fangrui166/GroundLock/old/read me.txt

版本介绍：
INT_GL_0.3 是北京第一台样机的程序；
INT_GL_0.3 - allsts 是地磁加超声波在后来自定义的协议上做的一版；
