fangrui166/GroundLock/doc/地锁6新主板电路图.pdf

# 地锁控制板更新：

# 1、取消集成超声波电路，改为外置超声波模块

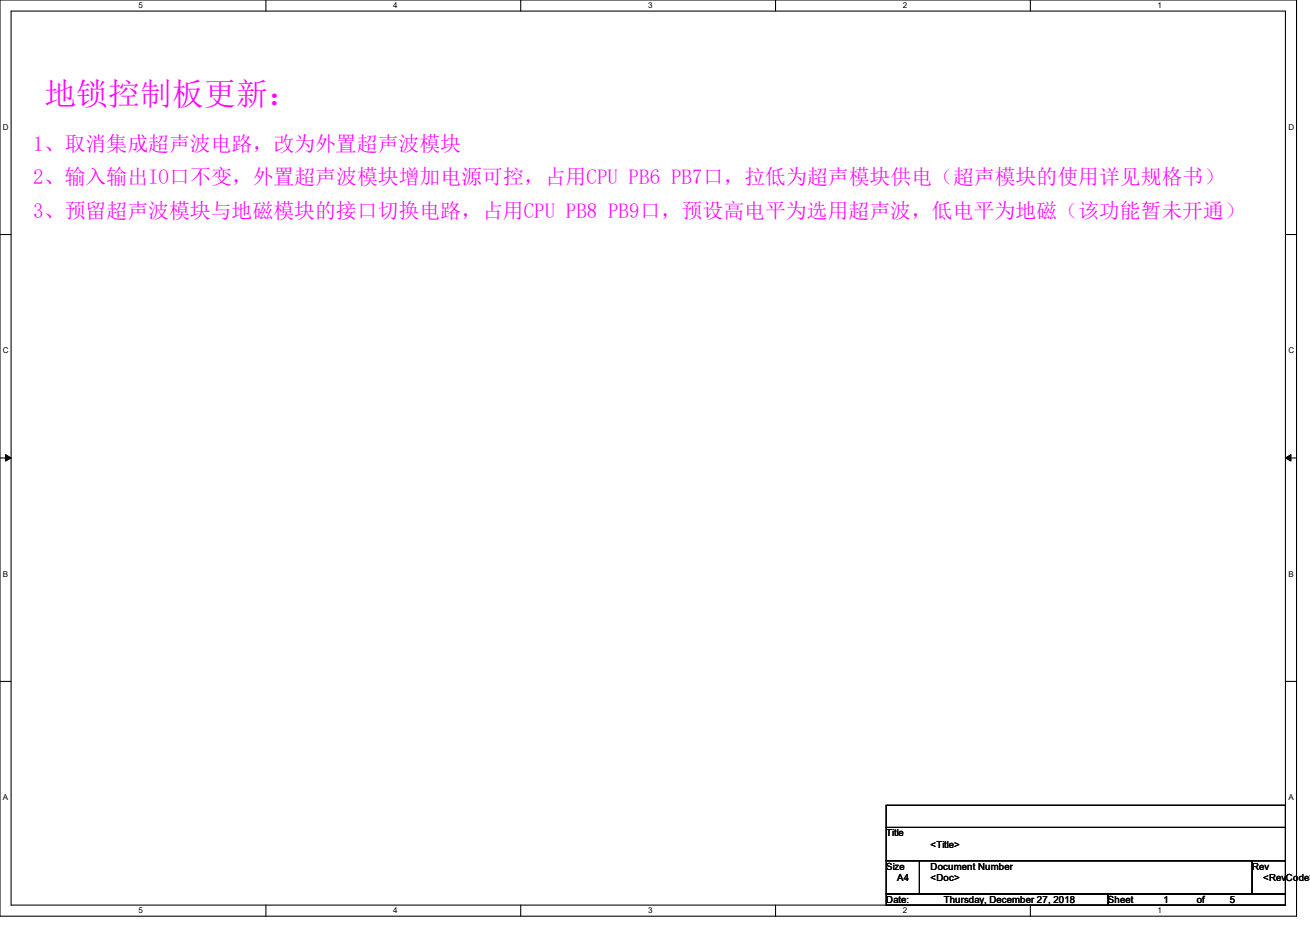
[picture p17: page 1]
Title Size; Document Number; Rev Date:; Sheet; of <Doc>; <RevCode>; <Title> A4; Thursday, December 27, 2018; 5 Title Size

2、输入输出IO口不变，外置超声波模块增加电源可控，占用CPU PB6 PB7口，拉低为超声模块供电（超声模块的使用详见规格书）
3、预留超声波模块与地磁模块的接口切换电路，占用CPU PB8 PB9口，预设高电平为选用超声波，低电平为地磁（该功能暂未开通）

# CPU主控

# OSC_IN OSC_OUT OSC_IN OSC_OUT ADC

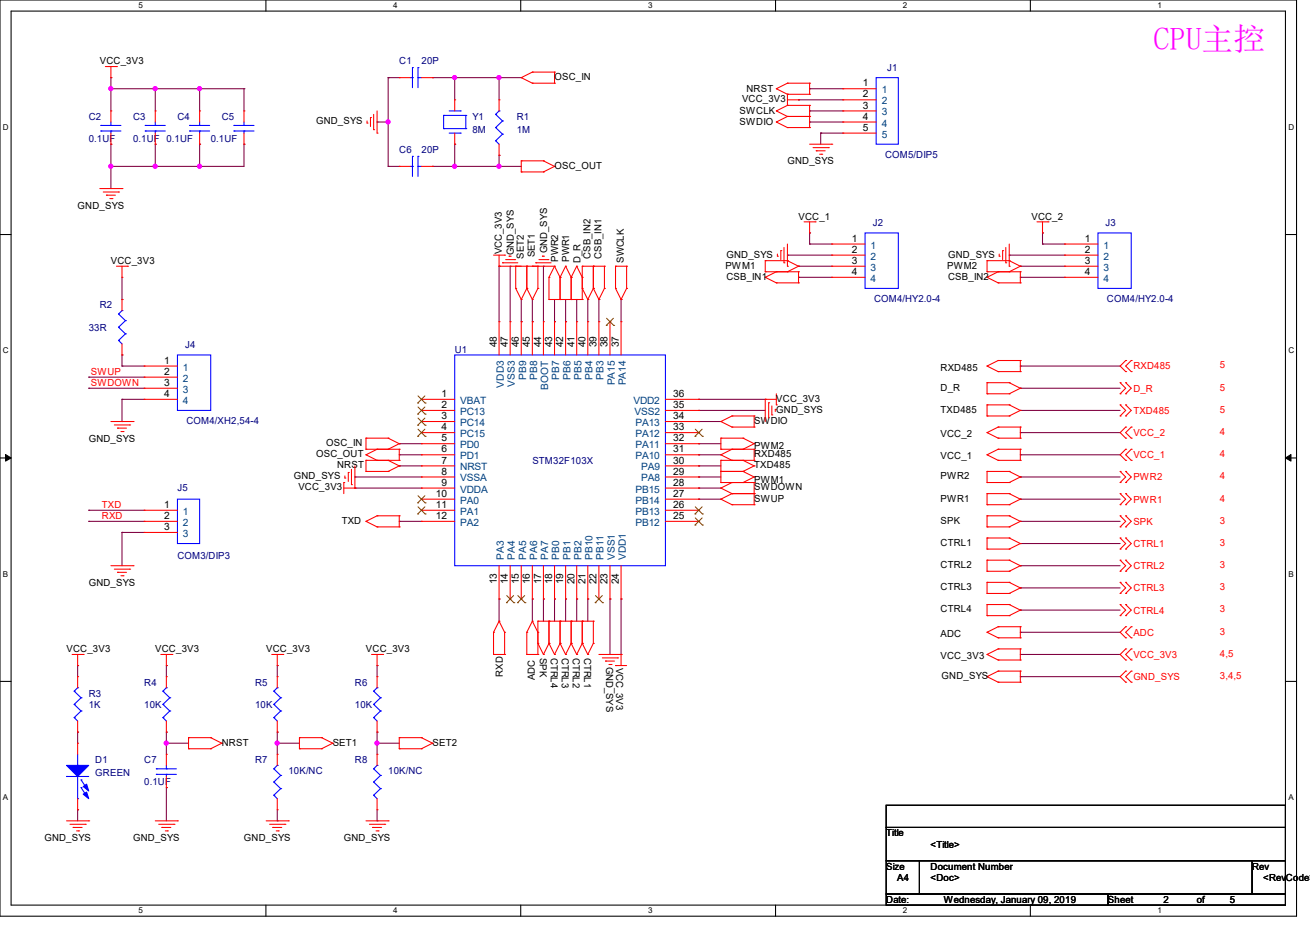
[picture p18: page 2]

# 升降电机驱动

# VCC_24V CTRL4 CTRL3 ADC

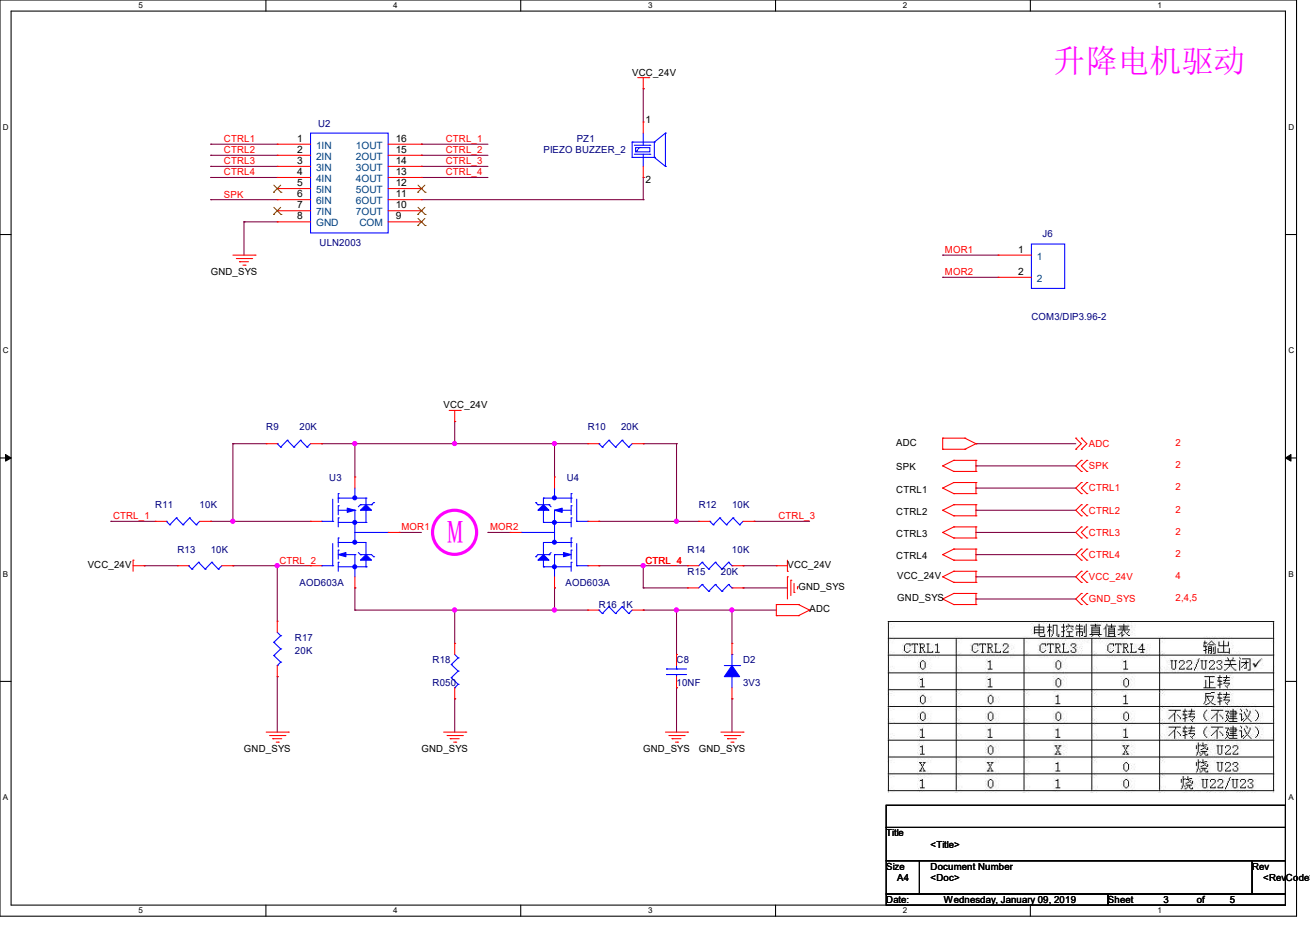
[picture p19: page 3]

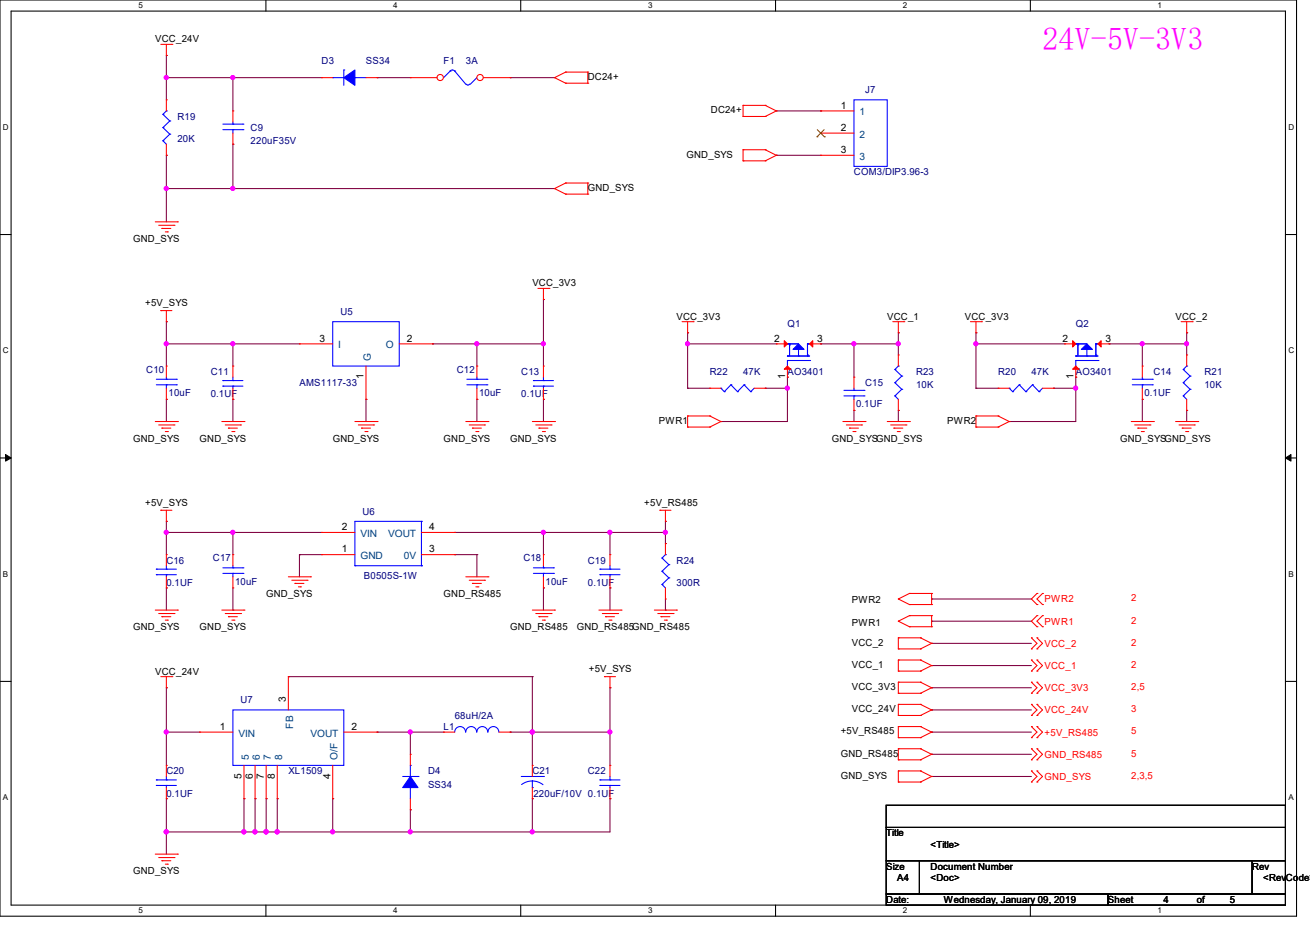
[picture p20: page 4]

RS485

# +5V_RS485 GND_RS485 GND_RS485

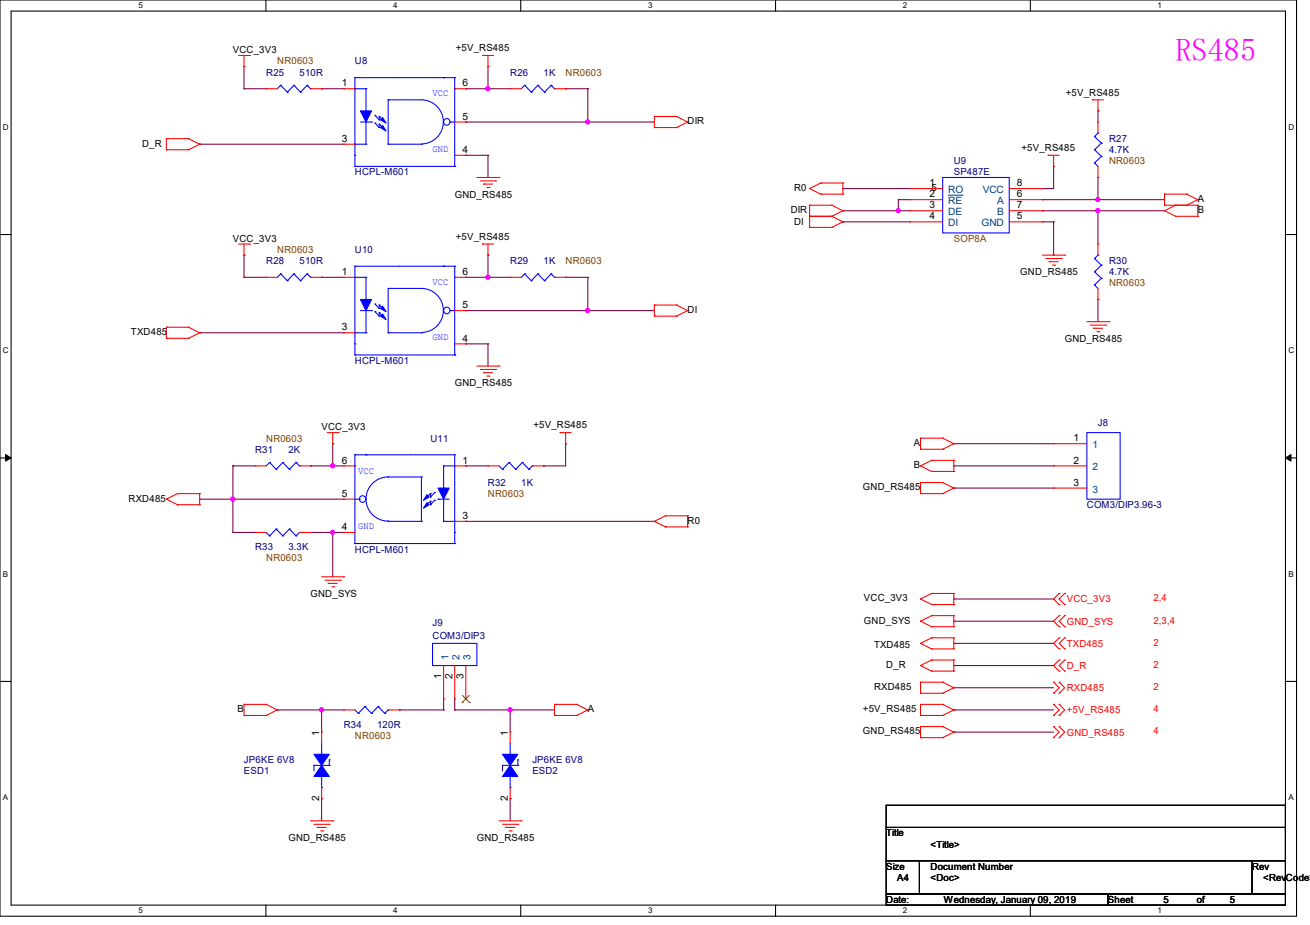
[picture p21: page 5]
