fangrui166/GroundLock/doc/地锁6主板电路图.pdf

# CPU主控

# OSC_IN OSC_OUT OSC_IN OSC_OUT ADC

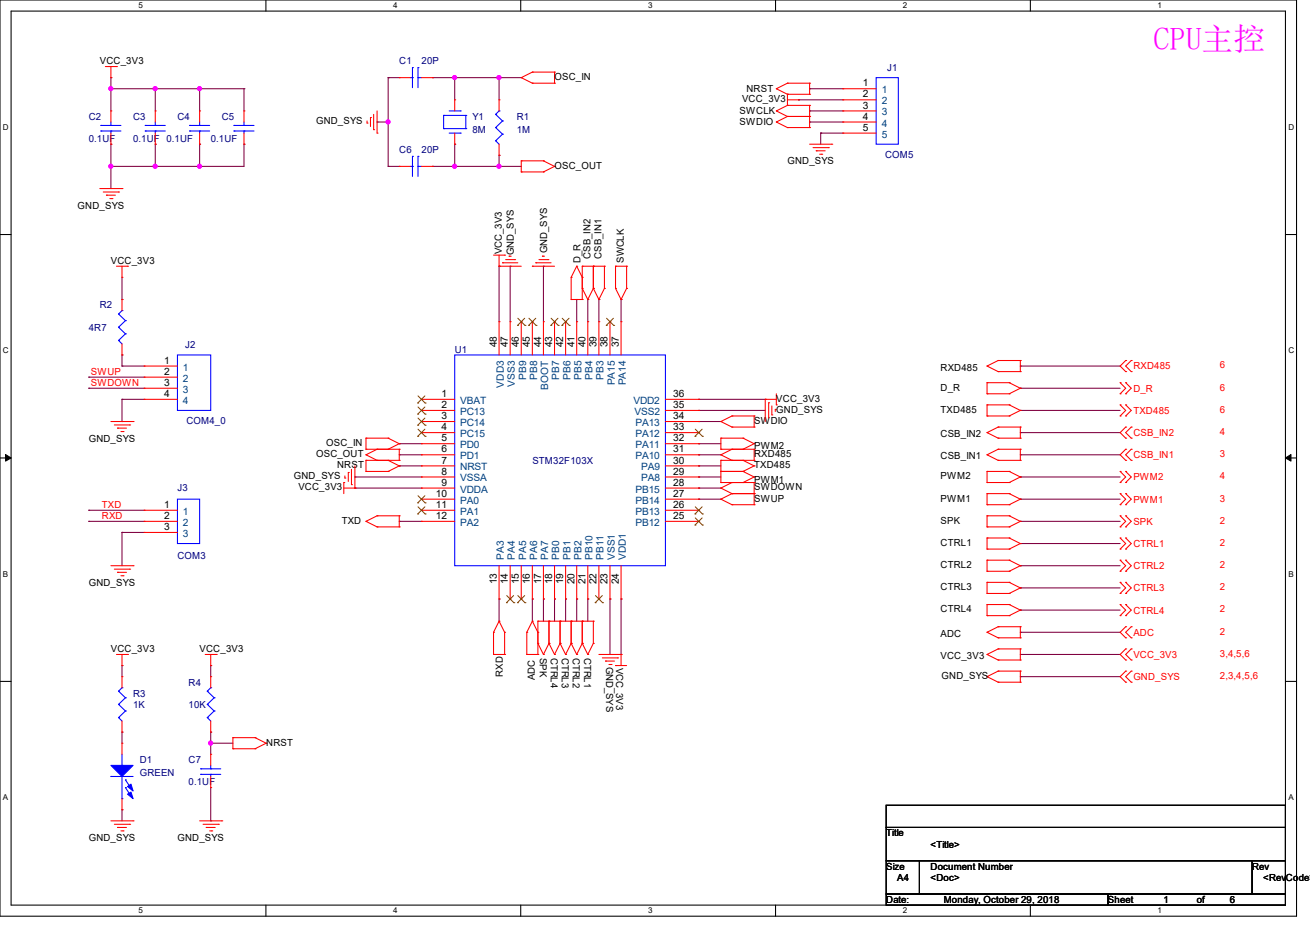
[picture p22: page 1]

# 升降电机驱动

# VCC_24V CTRL4 CTRL3 ADC

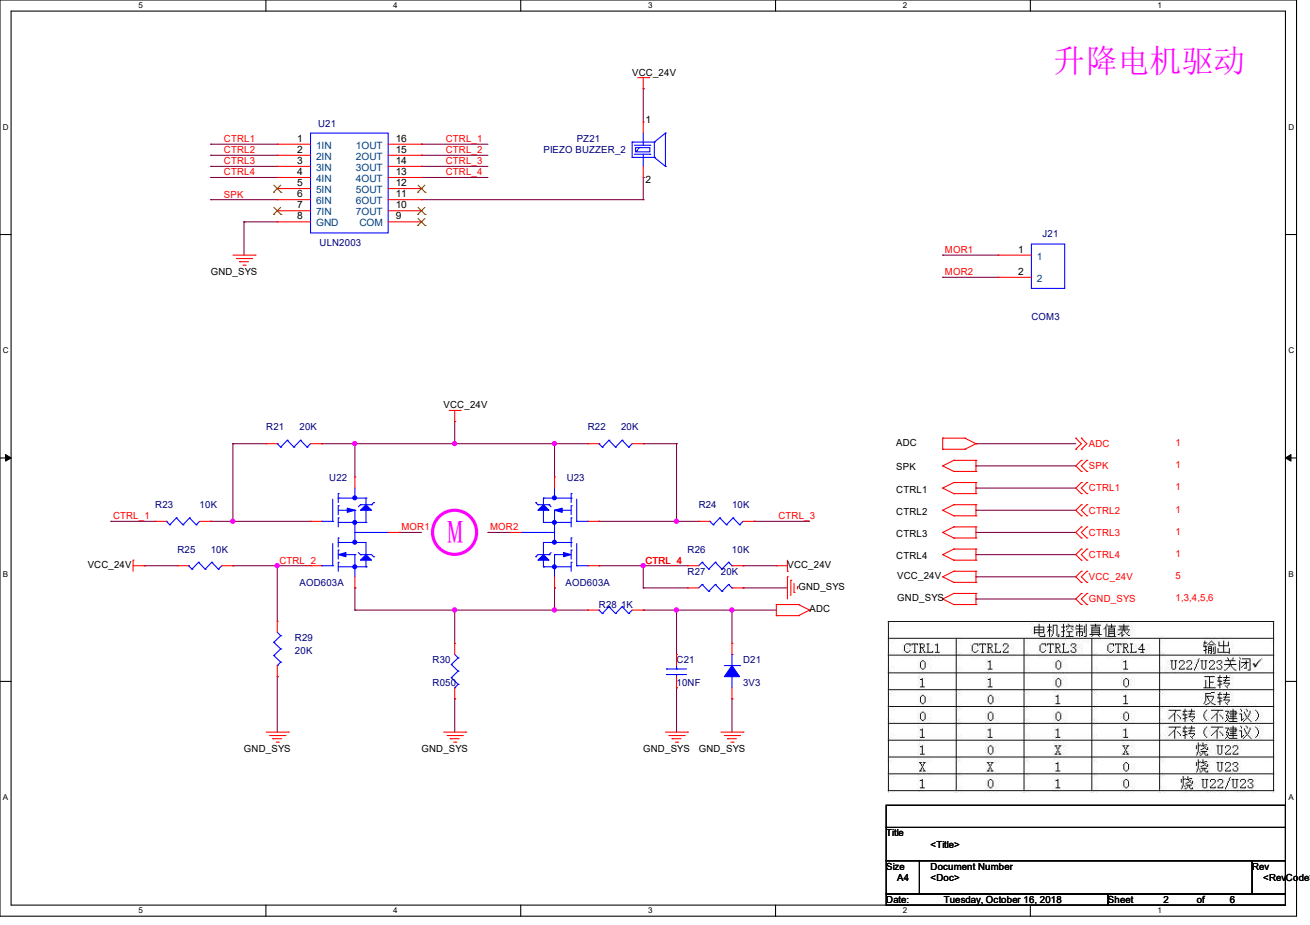
[picture p23: page 2]

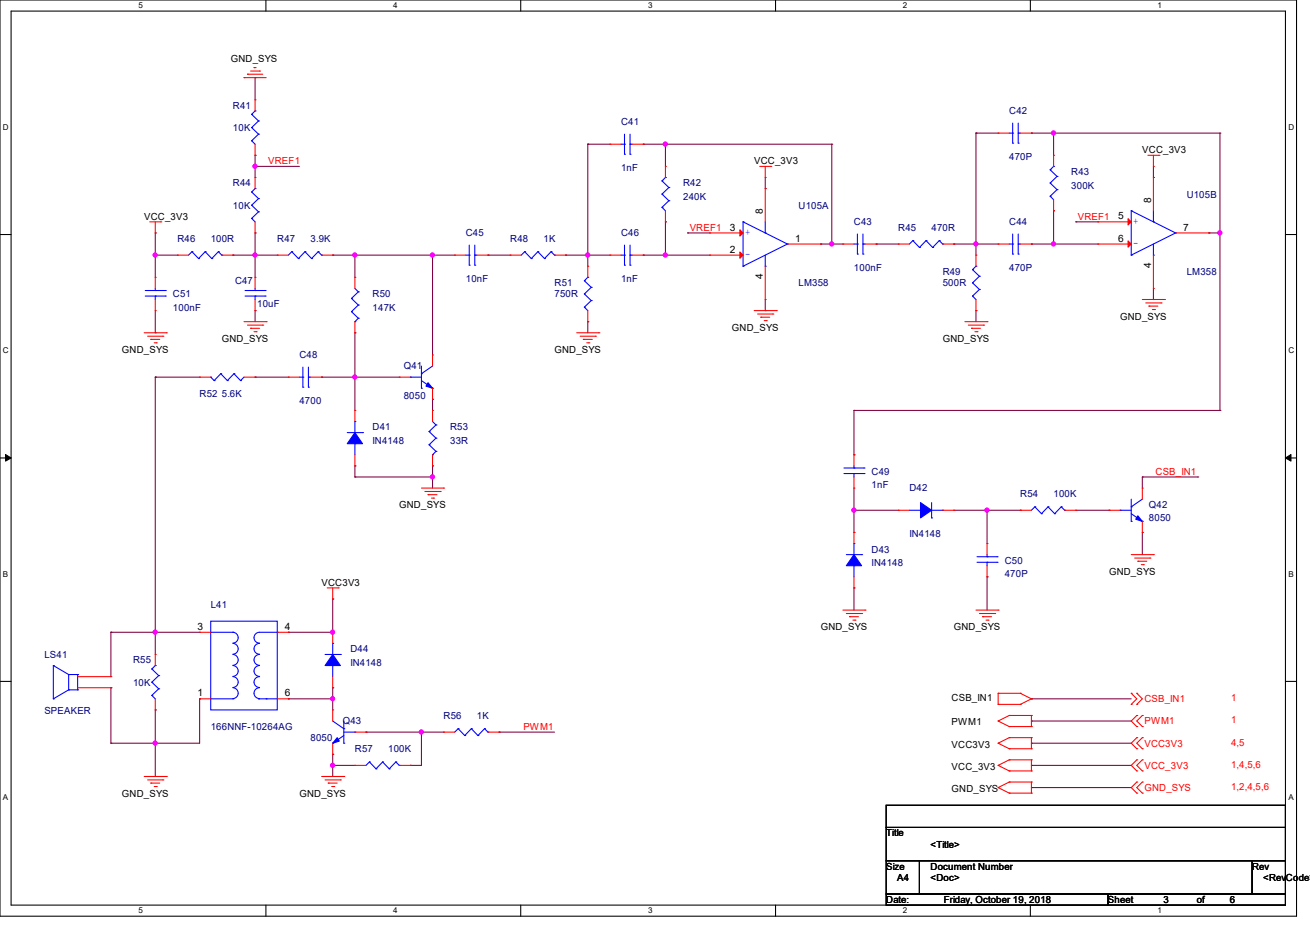
[picture p24: page 3]

147K | R76 | 1K
8050 Q63

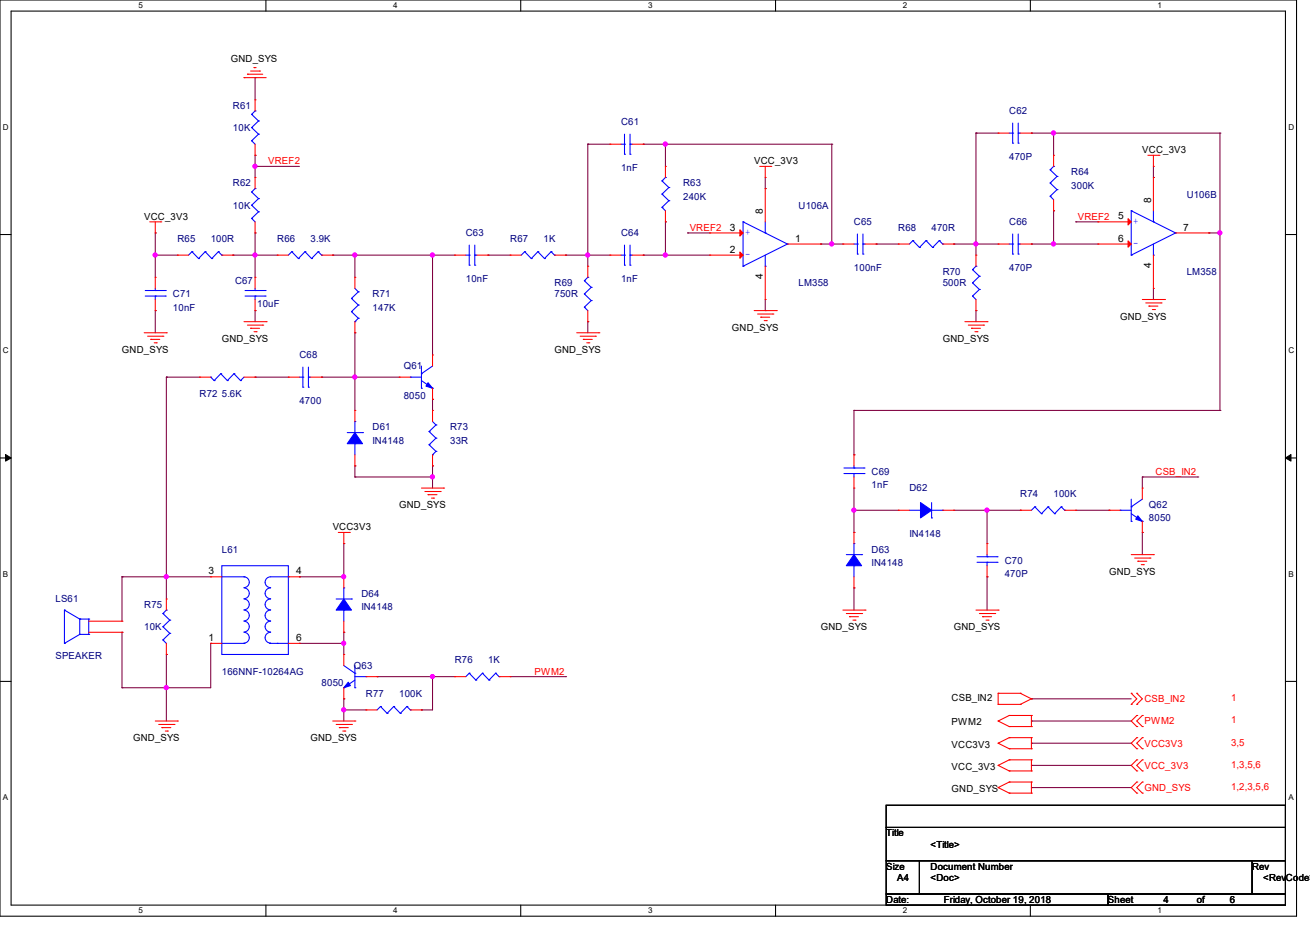
[picture p25: page 4]

# J81 COM3

# F81 3A C86

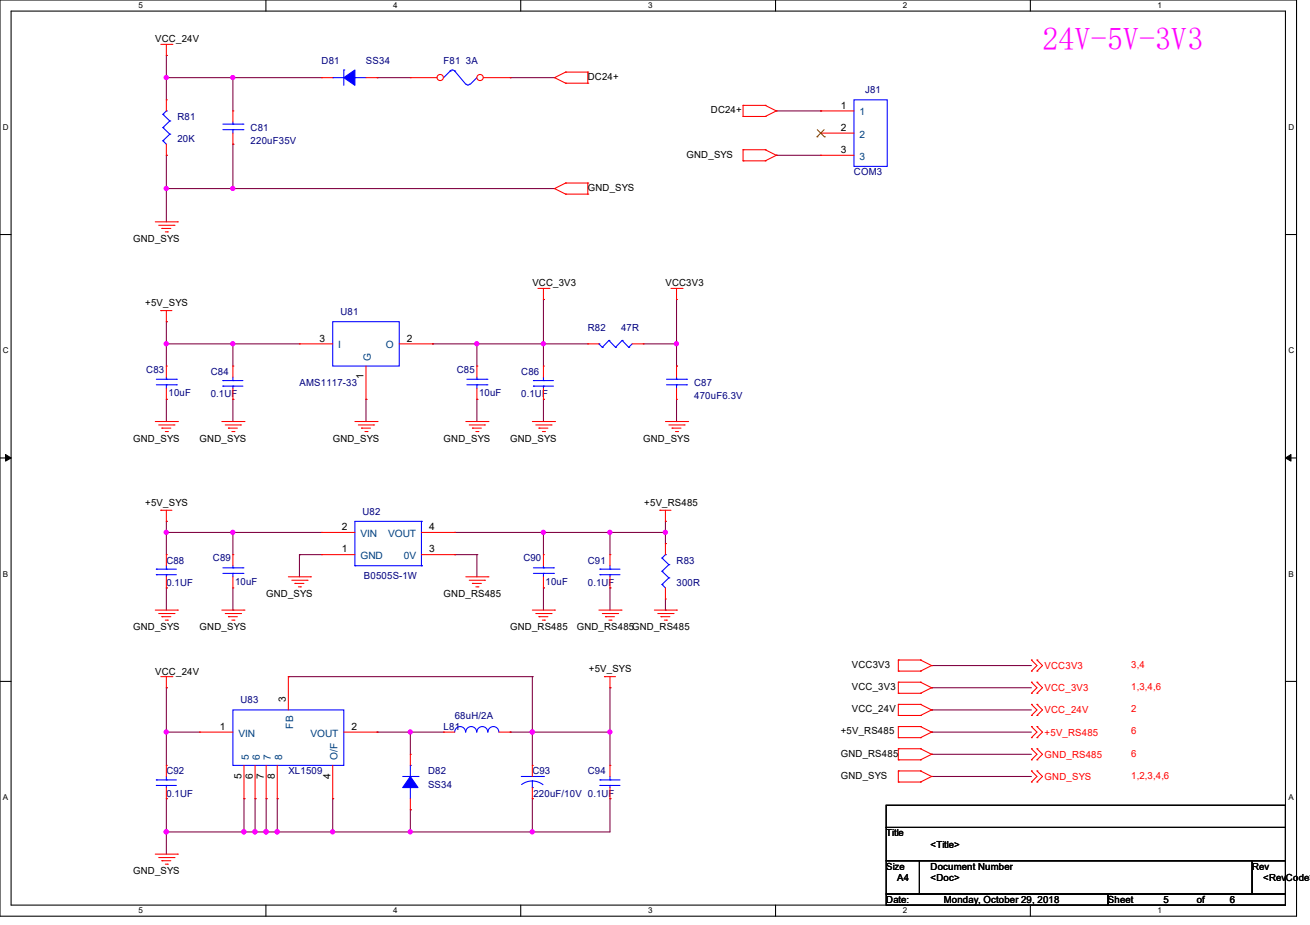
[picture p26: page 5]

RS485

# +5V_RS485 GND_RS485 GND_RS485

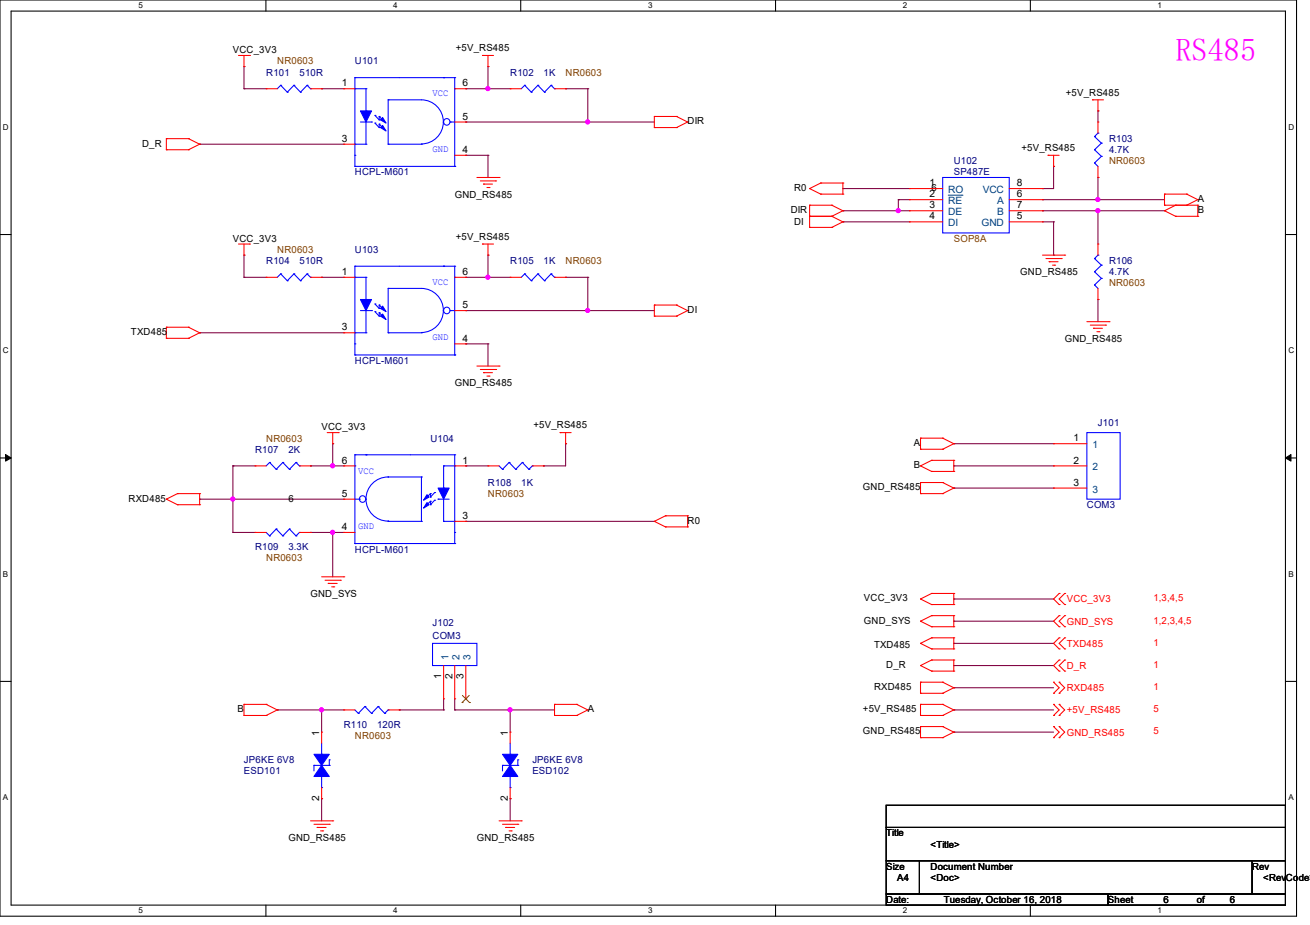
[picture p27: page 6]
