fangrui166/GroundLock/doc/地锁6光控板电路图.pdf

47K R1

# J1COM4_0

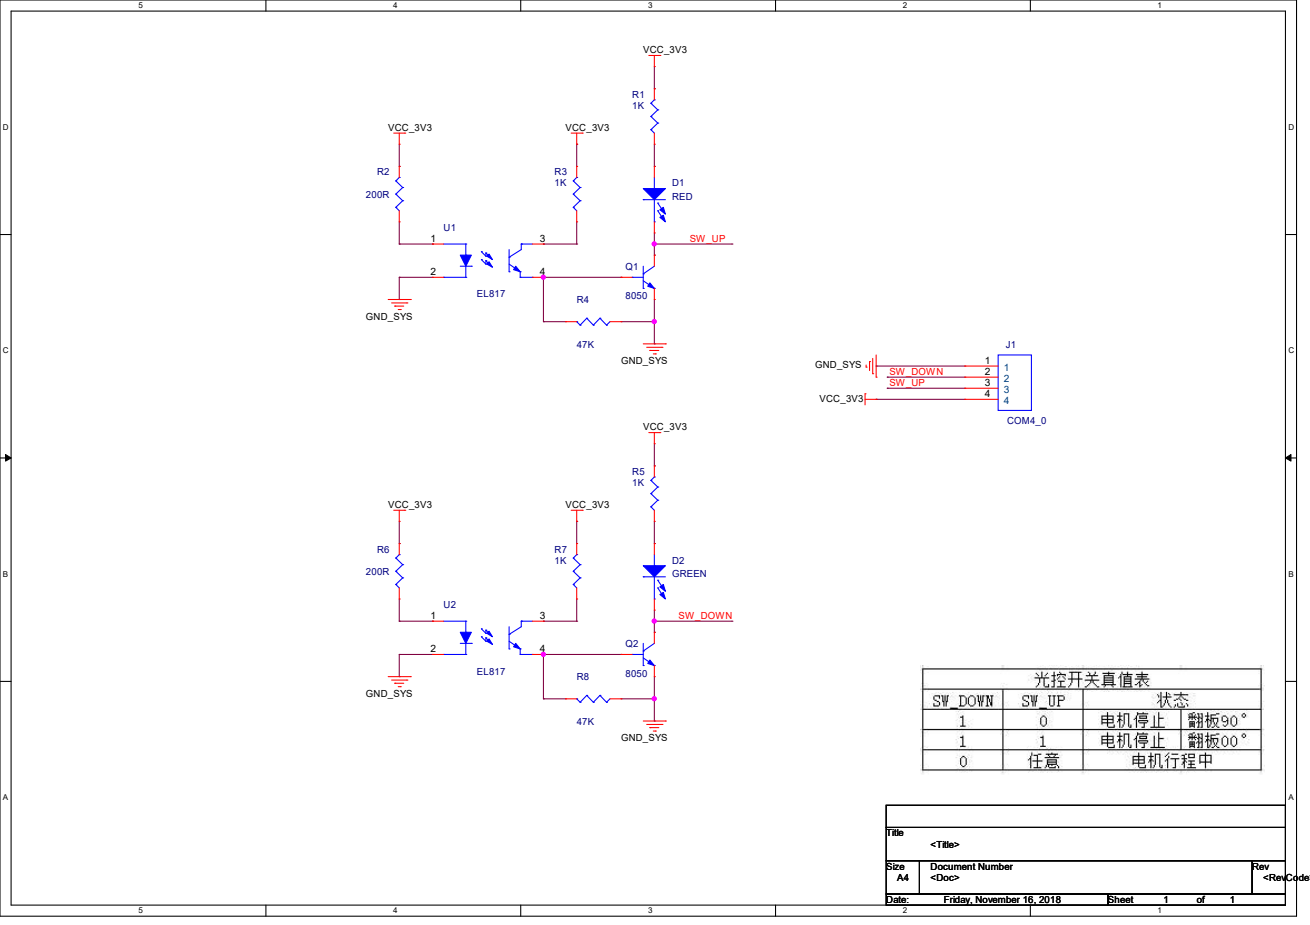
[picture p28: page 1]
