fangrui166/GroundLock/code/Src/main.c

/**
  ******************************************************************************
  * @file           : main.c
  * @brief          : Main program body
  ******************************************************************************
  ** This notice applies to any and all portions of this file
  * that are not between comment pairs USER CODE BEGIN and
  * USER CODE END. Other portions of this file, whether
  * inserted by the user or by software development tools
  * are owned by their respective copyright owners.
  *
  * COPYRIGHT(c) 2018 STMicroelectronics
  *
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
  ******************************************************************************
  */
/* Includes ------------------------------------------------------------------*/
#include "main.h"
#include "stm32f1xx_hal.h"
#include <clock.h>
#include <sys/process.h>
#include <sys/procinit.h>
#include <etimer.h>
#include <sys/ctimer.h>
#include <sys/autostart.h>
#include <contiki.h>
#include <autostart.h>
#include "uart_debug_drv.h"
#include "uart_485_drv.h"
#include "shellTask.h"
#include "trx485_if.h"
#include "flash_drv.h"
#include "wdt.h"
#include "adc.h"
#include "spk.h"
#include "gl_ctrl.h"
#include "gl_manager.h"
#include "rom_info.h"
#include "hlog.h"
#include "pwm.h"
#include "global.h"
#include "distance_manager.h"

CRC_HandleTypeDef hcrc;


RTC_HandleTypeDef hrtc;


/* USER CODE BEGIN PV */

/* USER CODE END PV */

void SystemClock_Config(void);
static void MX_GPIO_Init(void);
static void MX_RTC_Init(void);
static void MX_CRC_Init(void);

/* USER CODE BEGIN PFP */

/* USER CODE END PFP */

/**
  * @brief  The application entry point.
  *
  * @retval None
  */
int main(void)
{
    int retval;
  /* MCU Configuration----------------------------------------------------------*/

  /* Reset of all peripherals, Initializes the Flash interface and the Systick. */
  HAL_Init();

  /* Configure the system clock */
  SystemClock_Config();
  clock_init();
  process_init();
  process_start(&etimer_process,NULL);
  ctimer_init();

  /* Initialize all configured peripherals */
  MX_GPIO_Init();
  MX_RTC_Init();
  MX_CRC_Init();
  flash_init();
  DebugUart_Init();
  logi("%s build @ %s. version:%s\n", ROM_info, ROM_buildtime, ROM_version);
  global_variable_init();
  rom_info();
  hlog_init();
  TRx485Uart_Init();
  /* USER CODE BEGIN 2 */
  //autostart_start(autostart_processes);
  Shell_init();
  TRx485_Init();
  ADC_Init();
  SPK_Init();
  Ctrl_Init();
  Gl_ManagerInit();
  PWM_Init();
  Dist_Init();

  /* USER CODE END 2 */
  wdt_init();

  /* Infinite loop */
  /* USER CODE BEGIN WHILE */
  logi("Processes running\n");
  while(1){
      wdt_reset();
      retval = process_run();
      if((retval == 0) && (process_nevents() == 0)){
          /* Idle! */
          /* Stop processor clock */
          //HAL_PWR_EnterSTOPMode(PWR_LOWPOWERREGULATOR_ON, PWR_STOPENTRY_WFI);
      }
  }


  /* USER CODE END 3 */

}

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
