fangrui166/GroundLock/doc/GL/GL.ioc

Mcu.UserName=STM32F103CBTx
PA10.Signal=USART1_RX
PA11.Signal=S_TIM1_CH4
PA13.Signal=SYS_JTMS-SWDIO
PA14.Signal=SYS_JTCK-SWCLK
PA2.Signal=USART2_TX
PA3.Signal=USART2_RX
PA6.Signal=ADCx_IN6
PA8.Signal=S_TIM1_CH1
PA9.Signal=USART1_TX
PD0-OSC_IN.Signal=RCC_OSC_IN
PD1-OSC_OUT.Signal=RCC_OSC_OUT
