fangrui166/GroundLock/code/Src/pwm/pwm.c

#include "pwm.h"
#include "hlog.h"
#include "stm32f1xx_hal.h"
#include <sys/ctimer.h>
#include "distance_manager.h"


static uint8_t channel_a_start, channel_b_start;
#ifdef USE_PWM_TRGGER
TIM_HandleTypeDef htim1;
static uint32_t channel_count_a, channel_count_b;
static volatile uint32_t max_pwm_count_a = 9;
static volatile uint32_t max_pwm_count_b = 9;
#else
#define PWM_TRIGGER_TIME            5  //5ms
static struct ctimer trigger_timer1;
static struct ctimer trigger_timer2;
static void PWM_TriggerEndA(void *ptr)
{
    channel_a_start = 0;
    HAL_GPIO_WritePin(PWM_PORT, PWM_TRIGGER1, GPIO_PIN_RESET);
}
static void PWM_TriggerEndB(void *ptr)
{
    channel_b_start = 0;
    HAL_GPIO_WritePin(PWM_PORT, PWM_TRIGGER2, GPIO_PIN_RESET);
}
#endif


int PWM_ChannelAStart(uint32_t pwm_count)
{
    if(channel_a_start || channel_b_start) return -1;
    channel_a_start = 1;
    logi("%s\n", __func__);
#ifdef USE_PWM_TRGGER
    channel_count_a = 0;
    max_pwm_count_a = pwm_count;
    HAL_TIM_PWM_Start_IT(&htim1, TIM_CHANNEL_1);
#else
    HAL_GPIO_WritePin(PWM_POWER_PORT, PWM_POWER1_EN, GPIO_PIN_RESET);
    HAL_GPIO_WritePin(PWM_PORT, PWM_TRIGGER1, GPIO_PIN_SET);
    ctimer_set(&trigger_timer1, PWM_TRIGGER_TIME, PWM_TriggerEndA, NULL);
#endif
    return 0;
}
int PWM_ChannelBStart(uint32_t pwm_count)
{
    if(channel_b_start || channel_a_start) return -1;
    channel_b_start = 1;
    logi("%s\n", __func__);
#ifdef USE_PWM_TRGGER
    channel_count_b = 0;
    max_pwm_count_b = pwm_count;
    HAL_TIM_PWM_Start_IT(&htim1, TIM_CHANNEL_4);
#else
    HAL_GPIO_WritePin(PWM_POWER_PORT, PWM_POWER2_EN, GPIO_PIN_RESET);
    HAL_GPIO_WritePin(PWM_PORT, PWM_TRIGGER2, GPIO_PIN_SET);
    ctimer_set(&trigger_timer2, PWM_TRIGGER_TIME, PWM_TriggerEndB, NULL);
#endif
    return 0;
}
#ifdef USE_PWM_TRGGER

void HAL_TIM_PWM_PulseFinishedCallback(TIM_HandleTypeDef *htim)
{
    //logi("%s\n", __func__);
    if(htim->Instance == htim1.Instance){
        if(htim->Channel == HAL_TIM_ACTIVE_CHANNEL_1){
            if(++channel_count_a >= max_pwm_count_a){
                HAL_TIM_PWM_Stop_IT(&htim1, TIM_CHANNEL_1);
                channel_count_a = 0;
                channel_a_start = 0;
                logi("pwm a stop\n");
            }
        }
        if(htim->Channel == HAL_TIM_ACTIVE_CHANNEL_4){
            if(++channel_count_b >= max_pwm_count_b){
                HAL_TIM_PWM_Stop_IT(&htim1, TIM_CHANNEL_4);
                channel_count_b = 0;
                channel_b_start = 0;
                logi("pwm b stop\n");
            }
        }
    }
}
#endif
void PWM_CSBIN1_IRQHandler(void)
{
    if (__HAL_GPIO_EXTI_GET_IT(CSB_IN1) != RESET){
        __HAL_GPIO_EXTI_CLEAR_IT(CSB_IN1);
        if(HAL_GPIO_ReadPin(CSB_PORT, CSB_IN1)){
            DWT_CR         &= ~DWT_CR_CYCCNTENA;
            DWT_CYCCNT      = 0u;
            DWT_CR         |= DWT_CR_CYCCNTENA;
        }
        else{
            uint32_t T_us = DWT_CYCCNT/(SystemCoreClock/1000000);
            uint32_t distance_cm =T_us/58;
            HAL_GPIO_WritePin(PWM_POWER_PORT, PWM_POWER1_EN, GPIO_PIN_SET);
            logi("a distance :%d cm, %d us\n", distance_cm, T_us);
            Dist_MesureDone(distance_cm, PWM_Channel_A);
        }
    }

}
void PWM_CSBIN2_IRQHandler(void)
{
    if (__HAL_GPIO_EXTI_GET_IT(CSB_IN2) != RESET){
        __HAL_GPIO_EXTI_CLEAR_IT(CSB_IN2);
        if(HAL_GPIO_ReadPin(CSB_PORT, CSB_IN2)){
            DWT_CR         &= ~DWT_CR_CYCCNTENA;
            DWT_CYCCNT      = 0u;
            DWT_CR         |= DWT_CR_CYCCNTENA;
        }
        else{
            uint32_t T_us = DWT_CYCCNT/(SystemCoreClock/1000000);
            uint32_t distance_cm =T_us/58;
            HAL_GPIO_WritePin(PWM_POWER_PORT, PWM_POWER2_EN, GPIO_PIN_SET);
            logi("b distance :%d cm, %d us\n", distance_cm, T_us);
            Dist_MesureDone(distance_cm, PWM_Channel_B);
        }
    }
}
static void PWM_DWTInit(void)
{
    DEM_CR         |=  DEM_CR_TRCENA;
    DWT_CYCCNT      = 0u;
    DWT_CR         |= DWT_CR_CYCCNTENA;
}

#ifdef USE_PWM_TRGGER
static int PWM_TimInit(void)
{
    TIM_MasterConfigTypeDef sMasterConfig;
    TIM_OC_InitTypeDef sConfigOC;
    TIM_BreakDeadTimeConfigTypeDef sBreakDeadTimeConfig;

    htim1.Instance = TIM1;
    htim1.Init.Prescaler = 36;
    htim1.Init.CounterMode = TIM_COUNTERMODE_UP;
    htim1.Init.Period = 49;
    htim1.Init.ClockDivision = TIM_CLOCKDIVISION_DIV1;
    htim1.Init.RepetitionCounter = 0;
    htim1.Init.AutoReloadPreload = TIM_AUTORELOAD_PRELOAD_DISABLE;
    if (HAL_TIM_OC_Init(&htim1) != HAL_OK)
    {
      loge(__FILE__, __LINE__);
    }

    if (HAL_TIM_PWM_Init(&htim1) != HAL_OK)
    {
      loge(__FILE__, __LINE__);
    }

    sMasterConfig.MasterOutputTrigger = TIM_TRGO_RESET;
    sMasterConfig.MasterSlaveMode = TIM_MASTERSLAVEMODE_DISABLE;
    if (HAL_TIMEx_MasterConfigSynchronization(&htim1, &sMasterConfig) != HAL_OK)
    {
      loge(__FILE__, __LINE__);
    }

    sConfigOC.OCMode = TIM_OCMODE_PWM1;
    sConfigOC.Pulse = 25;
    sConfigOC.OCPolarity = TIM_OCPOLARITY_HIGH;
    sConfigOC.OCNPolarity = TIM_OCNPOLARITY_HIGH;
    sConfigOC.OCFastMode = TIM_OCFAST_DISABLE;
    sConfigOC.OCIdleState = TIM_OCIDLESTATE_RESET;
    sConfigOC.OCNIdleState = TIM_OCNIDLESTATE_RESET;
    if (HAL_TIM_OC_ConfigChannel(&htim1, &sConfigOC, TIM_CHANNEL_1) != HAL_OK)
    {
      loge(__FILE__, __LINE__);
    }

    sConfigOC.OCMode = TIM_OCMODE_PWM1;
    if (HAL_TIM_PWM_ConfigChannel(&htim1, &sConfigOC, TIM_CHANNEL_4) != HAL_OK)
    {
      loge(__FILE__, __LINE__);
    }

    sBreakDeadTimeConfig.OffStateRunMode = TIM_OSSR_DISABLE;
    sBreakDeadTimeConfig.OffStateIDLEMode = TIM_OSSI_DISABLE;
    sBreakDeadTimeConfig.LockLevel = TIM_LOCKLEVEL_OFF;
    sBreakDeadTimeConfig.DeadTime = 0;
    sBreakDeadTimeConfig.BreakState = TIM_BREAK_DISABLE;
    sBreakDeadTimeConfig.BreakPolarity = TIM_BREAKPOLARITY_HIGH;
    sBreakDeadTimeConfig.AutomaticOutput = TIM_AUTOMATICOUTPUT_DISABLE;
    if (HAL_TIMEx_ConfigBreakDeadTime(&htim1, &sBreakDeadTimeConfig) != HAL_OK)
    {
      loge(__FILE__, __LINE__);
    }

    extern void HAL_TIM_MspPostInit(TIM_HandleTypeDef* htim);

    HAL_TIM_MspPostInit(&htim1);

    HAL_NVIC_SetPriority(TIM1_CC_IRQn, 2, 7);
    HAL_NVIC_EnableIRQ(TIM1_CC_IRQn);
    return 0;
}
#endif
int PWM_GpioInit(void)
{
    GPIO_InitTypeDef GPIO_InitStruct;
    __HAL_RCC_GPIOB_CLK_ENABLE();
    __HAL_RCC_GPIOA_CLK_ENABLE();

    GPIO_InitStruct.Pin = CSB_IN1 | CSB_IN2;
    GPIO_InitStruct.Mode = GPIO_MODE_IT_RISING_FALLING;
    GPIO_InitStruct.Pull = GPIO_PULLUP;
    GPIO_InitStruct.Speed = GPIO_SPEED_FREQ_HIGH;
    HAL_GPIO_Init(CSB_PORT, &GPIO_InitStruct);
#ifndef USE_PWM_TRGGER
    GPIO_InitStruct.Pin = PWM_POWER1_EN | PWM_POWER2_EN;
    GPIO_InitStruct.Mode = GPIO_MODE_OUTPUT_PP;
    GPIO_InitStruct.Pull = GPIO_PULLUP;
    GPIO_InitStruct.Speed = GPIO_SPEED_FREQ_HIGH;
    HAL_GPIO_Init(PWM_POWER_PORT, &GPIO_InitStruct);
    HAL_GPIO_WritePin(PWM_POWER_PORT, PWM_POWER1_EN, GPIO_PIN_SET);
    HAL_GPIO_WritePin(PWM_POWER_PORT, PWM_POWER2_EN, GPIO_PIN_SET);

    GPIO_InitStruct.Pin = PWM_TRIGGER1 | PWM_TRIGGER2;
    GPIO_InitStruct.Mode = GPIO_MODE_OUTPUT_PP;
    GPIO_InitStruct.Pull = GPIO_PULLUP;
    GPIO_InitStruct.Speed = GPIO_SPEED_FREQ_HIGH;
    HAL_GPIO_Init(PWM_PORT, &GPIO_InitStruct);
    HAL_GPIO_WritePin(PWM_PORT, PWM_TRIGGER1, GPIO_PIN_RESET);
    HAL_GPIO_WritePin(PWM_PORT, PWM_TRIGGER2, GPIO_PIN_RESET);

#endif

    HAL_NVIC_SetPriority(EXTI3_IRQn, 0, 0);
    HAL_NVIC_EnableIRQ(EXTI3_IRQn);

    HAL_NVIC_SetPriority(EXTI4_IRQn, 0, 0);
    HAL_NVIC_EnableIRQ(EXTI4_IRQn);
    return 0;
}
int PWM_Init(void)
{
    #ifdef USE_PWM_TRGGER
    PWM_TimInit();
    #endif
    PWM_GpioInit();
    PWM_DWTInit();
    return 0;
}
