fangrui166/GroundLock/(commit log)

2018-11-16 init codebase use STM32CubeMX created
    [1000pkt-64len.csv, arm7_wig.cfg, arm7_wig_flash.cfg, arm7_wig_reset.cfg, default.cfg, econotag-flash-test.cfg, sample.cfg, wwwroot.cfg]
2018-11-17 1. portting Contiki OS 2. support uart2 for shell
2018-11-19 fixed uart shell issue
    [main.c, shellTask.c, uart_debug_drv.c]
2018-11-24 add adc , lock, ctrl diver ...
2018-12-01 verify motor
2018-12-01 misc command ,and power reboot
    [shellTask.c]
2018-12-02 add pwm dirver
2018-12-29 optimeze uart driver
2018-12-29 fixed creat fw with version
    [global.h, rom_info.h]
2019-01-19 support pwm power contrl
