fangrui166/GroundLock/(notices)

Notices in the files:
code/Src/main.c:
(C) COPYRIGHT STMicroelectronics *****END OF FILE
